bdarrenn/DESIGN-Fpga-Based-Water-Quality-Monitoring-System/hardware/Design-1-Draft.kicad_pcb

## KiCad design hardware/Design-1-Draft.kicad_pcb (2026-08-05)

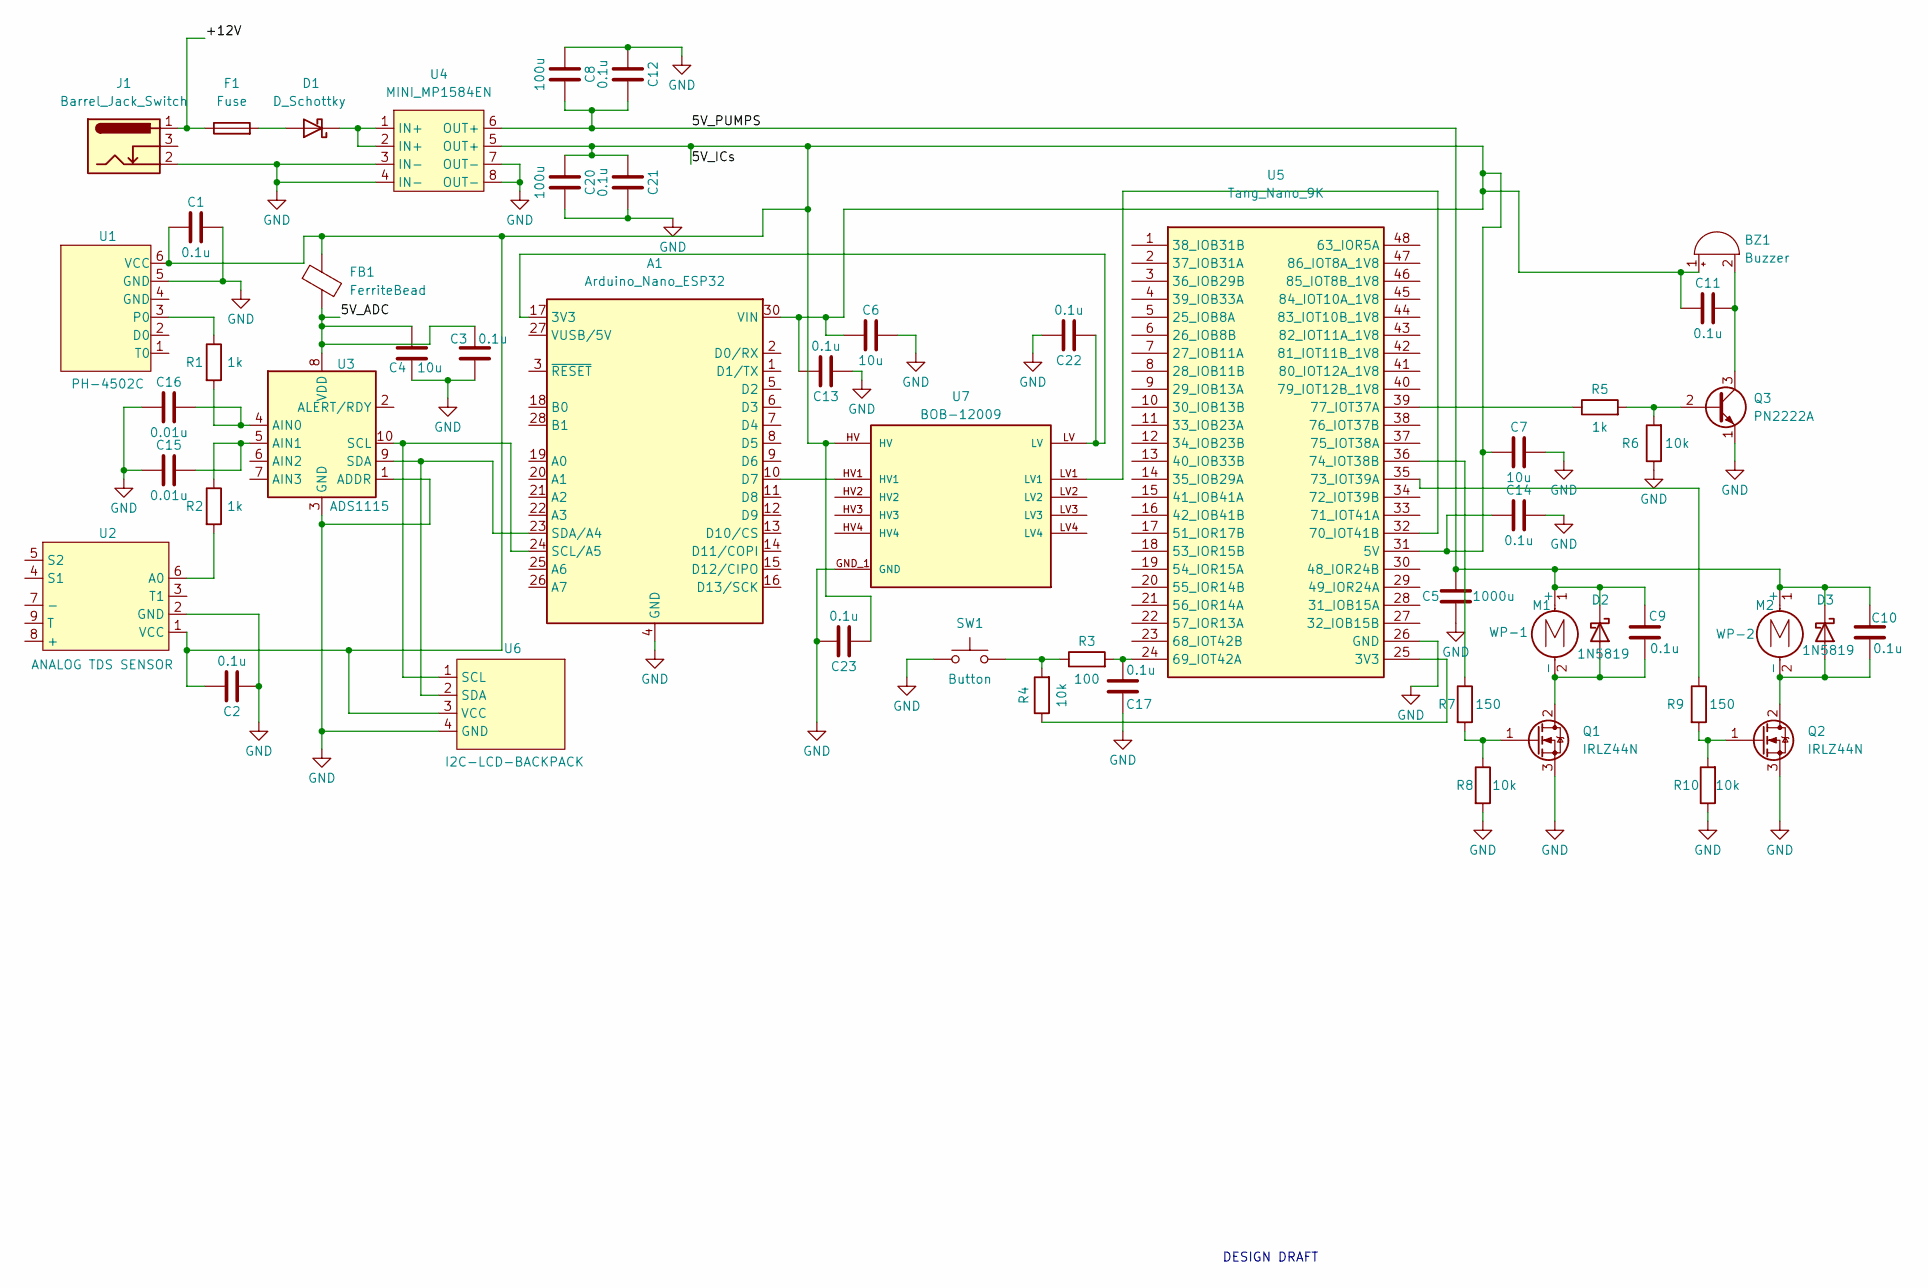
[picture p1: schematic Design-1-Draft.kicad_sch]

Parts:
A1: Arduino_Nano_ESP32; Arduino_Nano
BZ1: Buzzer; PinHeader_1x02_P2.54mm_Vertical
C1, C2, C3, C9, C10, C11, C12, C13, C14, C17, C21, C22, C23: 0.1u; C_Disc_D5.0mm_W2.5mm_P5.00mm
C4, C6, C7: 10u; C_Radial_D6.3mm_H5.0mm_P2.50mm
C5: 1000u; CP_Radial_D10.0mm_P5.00mm
C8, C20: 100u; C_Radial_D6.3mm_H5.0mm_P2.50mm
C15, C16: 0.01u; C_Disc_D5.0mm_W2.5mm_P5.00mm
D1: D_Schottky; D_DO-41_SOD81_P10.16mm_Horizontal
D2, D3: 1N5819; D_DO-41_SOD81_P10.16mm_Horizontal
F1: Fuse; Fuseholder_Clip-5x20mm_Keystone_3512P_Inline_P23.62x7.27mm_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
FB1: FerriteBead; R_Axial_DIN0207_L6.3mm_D2.5mm_P10.16mm_Horizontal
J1: Barrel_Jack_Switch; BarrelJack_Horizontal
M1: WP-1; PinHeader_1x02_P2.54mm_Vertical
M2: WP-2; PinHeader_1x02_P2.54mm_Vertical
Q1, Q2: IRLZ44N; TO-220-3_Vertical
Q3: PN2222A; TO-92_Inline
R1, R2, R5: 1k; R_Axial_DIN0207_L6.3mm_D2.5mm_P10.16mm_Horizontal
R3: 100; R_Axial_DIN0207_L6.3mm_D2.5mm_P10.16mm_Horizontal
R4, R6, R8, R10: 10k; R_Axial_DIN0207_L6.3mm_D2.5mm_P10.16mm_Horizontal
R7, R9: 150; R_Axial_DIN0207_L6.3mm_D2.5mm_P10.16mm_Horizontal
SW1: Button; PinHeader_1x02_P2.54mm_Vertical
U1: PH-4502C
U2: TDS-ANALOG-SENSOR
U3: ADS1115
U4: SRT_MPT1584EN_Module
U5: Tang_Nano_9K; DIP-48_TangNano9K
U6: I2C-BACKPACK-LCD
U7: BOB-12009; CONV_BOB-12009; PARTREV 01

Connections:
/5V_ADC: C3.2, C4.2, FB1.2, U3.8 (VDD)
/5V_ICs: A1.30 (VIN), BZ1.1 (+), C1.1, C2.2, C6.1, C7.1, C11.1, C13.2, C14.1, C20.1, C21.1, C23.1, FB1.1, U1.6 (VCC), U2.1 (VCC), U4.5 (OUT+), U5.31 (5V), U6.3 (VCC), U7.HV
/5V_PUMPS: C5.2, C8.2, C9.1, C10.1, C12.2, D2.1 (K), D3.1 (K), M1.1 (+), M2.1 (+), U4.6 (OUT+)
/+12V: F1.1, J1.1
GND: A1.4 (GND), A1.29 (GND), C1.2, C2.1, C3.1, C4.1, C5.1, C6.2, C7.2, C8.1, C12.1, C13.1, C14.2, C15.1, C16.1, C17.2, C20.2, C21.2, C22.2, C23.2, J1.2, Q1.3 (S), Q2.3 (S), Q3.1 (E), R6.1, R8.2, R10.1, SW1.1, U1.5 (GND), U2.2 (GND), U3.1 (ADDR), U3.3 (GND), U4.3 (IN-), U4.4 (IN-), U4.7 (OUT-), U4.8 (OUT-), U5.26 (GND), U6.4 (GND), U7.GND_1 (GND), U7.GND_2 (GND)
unnamed: A1.17 (3V3), C22.1, U7.LV
unnamed: A1.10 (D7), U7.HV1
unnamed: A1.24 (SCL/A5), U3.10 (SCL), U6.1 (SCL)
unnamed: A1.23 (SDA/A4), U3.9 (SDA), U6.2 (SDA)
unnamed: BZ1.2 (-), C11.2, Q3.3 (C)
unnamed: D1.2 (A), F1.2
unnamed: D1.1 (K), U4.1 (IN+), U4.2 (IN+)
unnamed: C9.2, D2.2 (A), M1.2 (-), Q1.2 (D)
unnamed: C10.2, D3.2 (A), M2.2 (-), Q2.2 (D)
unnamed: Q1.1 (G), R7.2, R8.1
unnamed: Q2.1 (G), R9.2, R10.2
unnamed: Q3.2 (B), R5.2, R6.2
unnamed: R3.1, R4.2, SW1.2
unnamed: R1.1, U1.3 (P0)
unnamed: R2.2, U2.6 (A0)
unnamed: C16.2, R1.2, U3.4 (AIN0)
unnamed: C15.2, R2.1, U3.5 (AIN1)
unnamed: R4.1, U5.25 (3V3)
unnamed: C17.1, R3.2, U5.24 (69_IOT42A)
unnamed: U5.32 (70_IOT41B), U7.LV1
unnamed: R9.1, U5.35 (73_IOT39A)
unnamed: R7.1, U5.36 (74_IOT38B)
unnamed: R5.1, U5.39 (77_IOT37A)

Notes on the sheet:
DESIGN DRAFT

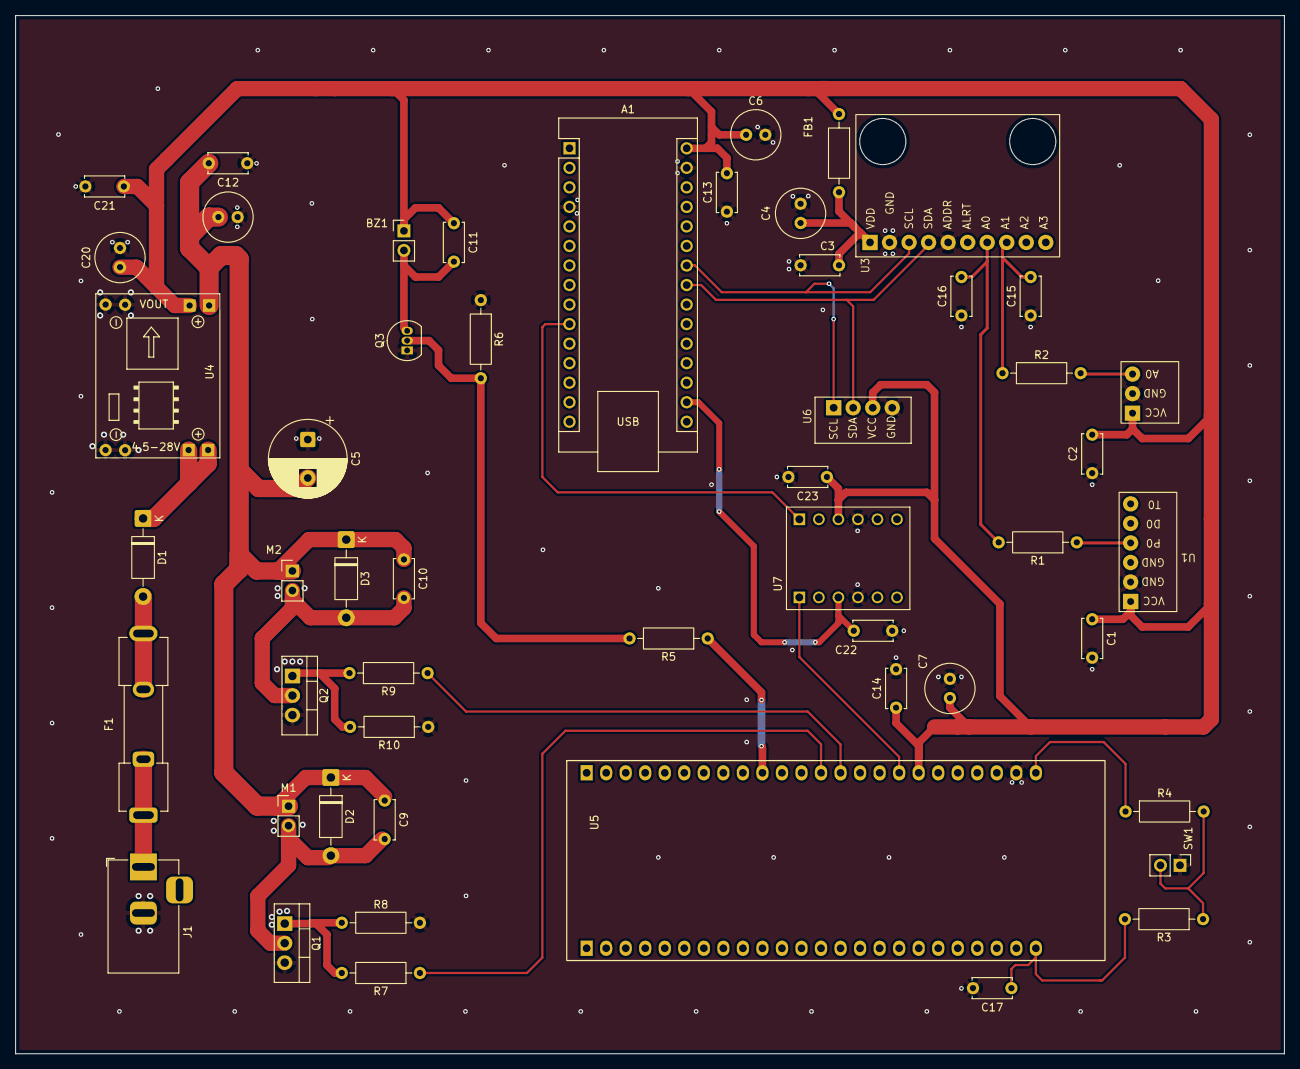
[picture p2: board Design-1-Draft.kicad_pcb from above]

Board: 2 copper layers, 165.0 x 135.0 mm, 52 parts (0 on the bottom side), 28 nets.
