bdarrenn/DESIGN-Fpga-Based-Water-Quality-Monitoring-System/(commit log)

2026-02-04 Renaming Symbols
    [Design-1-Draft.kicad_sch]
2026-02-04 Added Symbol and Footprint Libraries (+ yung mga custom na ginawa ko). kung ayaw maview symbols add niyo sa libraries niyo.
2026-02-05 added fuse, schottky, at adc sa pcb
    [Design-1-Draft.kicad_pcb]
2026-02-05 Assigned footprints sa schematic (kulang pa ginagawan ko pa yung iba)
    [Design-1-Draft.kicad_pcb, Design-1-Draft.kicad_sch]
2026-02-05 added footprints to pcb (not yet complete)
    [Design-1-Draft.kicad_pcb]
2026-02-06 updated footprint lib
    [Design-1-Draft.kicad_pcb, Design-1-Draft.kicad_sch]
2026-02-06 updated footprints
    [Design-1-Draft.kicad_pcb, Design-1-Draft.kicad_sch]
2026-02-06 some updates footprint and pcb
    [Design-1-Draft.kicad_pcb, Design-1-Draft.kicad_sch]
2026-02-07 updated custom footprints
2026-02-08 Updated Footprint Library for custom footprints. Fixed PCB footprints, traces nalang kulang
    [Design-1-Draft.kicad_pcb, Design-1-Draft.kicad_sch]
2026-02-08 realigned some footprints, figuring out trace paths
    [Design-1-Draft.kicad_pcb]
2026-02-08 fixed footprint text
    [Design-1-Draft.kicad_pcb]
2026-02-08 added some traces
    [Design-1-Draft.kicad_pcb]
2026-02-09 updated schematic and pcb
    [Design-1-Draft.kicad_pcb, Design-1-Draft.kicad_sch]
2026-02-10 updated pcb
    [Design-1-Draft.kicad_pcb]
2026-02-10 updated PCB and footprint lib
    [Design-1-Draft.kicad_pcb]
2026-02-10 updated PCB (fixed some trace angles)
    [Design-1-Draft.kicad_pcb]
2026-02-10 updated pcb (added top and bottom GND pour, hide nalang kung may gustong iedit
    [Design-1-Draft.kicad_pcb]
2026-02-10 updated PCB (added vias for ground pours)
    [Design-1-Draft.kicad_pcb]
2026-02-10 updated PCB, ground pour and vias
    [Design-1-Draft.kicad_pcb]
2026-06-05 modified schem, wala pang pcb
    [Design-1-Draft.kicad_sch]
2026-06-06 added arduino code
2026-06-11 schem and symbols/footprint for shifter
    [Design-1-Draft.kicad_sch]
2026-06-17 revised schem, renamed GND symbols > GND zones, removed buck converter, 5V to arduino & adc
    [Design-1-Draft.kicad_sch]
2026-06-17 schem: buck converter added > one ground plane pcb: NEW component placement, need traces and ground fills
    [Design-1-Draft.kicad_pcb]
2026-06-17 updated pcb, traces & ground fills pa
    [Design-1-Draft.kicad_pcb]
2026-06-17 updated PCB, traces and ground fills pa
    [Design-1-Draft.kicad_pcb]
2026-06-18 Updated PCB & SCHEM
    [Design-1-Draft.kicad_pcb, Design-1-Draft.kicad_sch]
2026-06-19 updated schem (added multiple caps & 2 flyback diodes @pumps)
    [Design-1-Draft.kicad_pcb, Design-1-Draft.kicad_sch]
2026-06-19 adding logic shifter footprint
2026-06-26 Updated PCB and Schem
    [Design-1-Draft.kicad_pcb, Design-1-Draft.kicad_sch]
2026-08-03 Updated schem & PCB, caps not removed
    [Design-1-Draft.kicad_pcb, Design-1-Draft.kicad_sch]
2026-08-05 Updated schem and PCB, switched SDA & SCL lines on arduino pins, removed filter caps @ arduino pins
    [Design-1-Draft.kicad_pcb, Design-1-Draft.kicad_sch]
